jjagn/ebike-computer/ebike-controller.kicad_pcb

## KiCad design ebike-controller.kicad_pcb (2026-10-02)

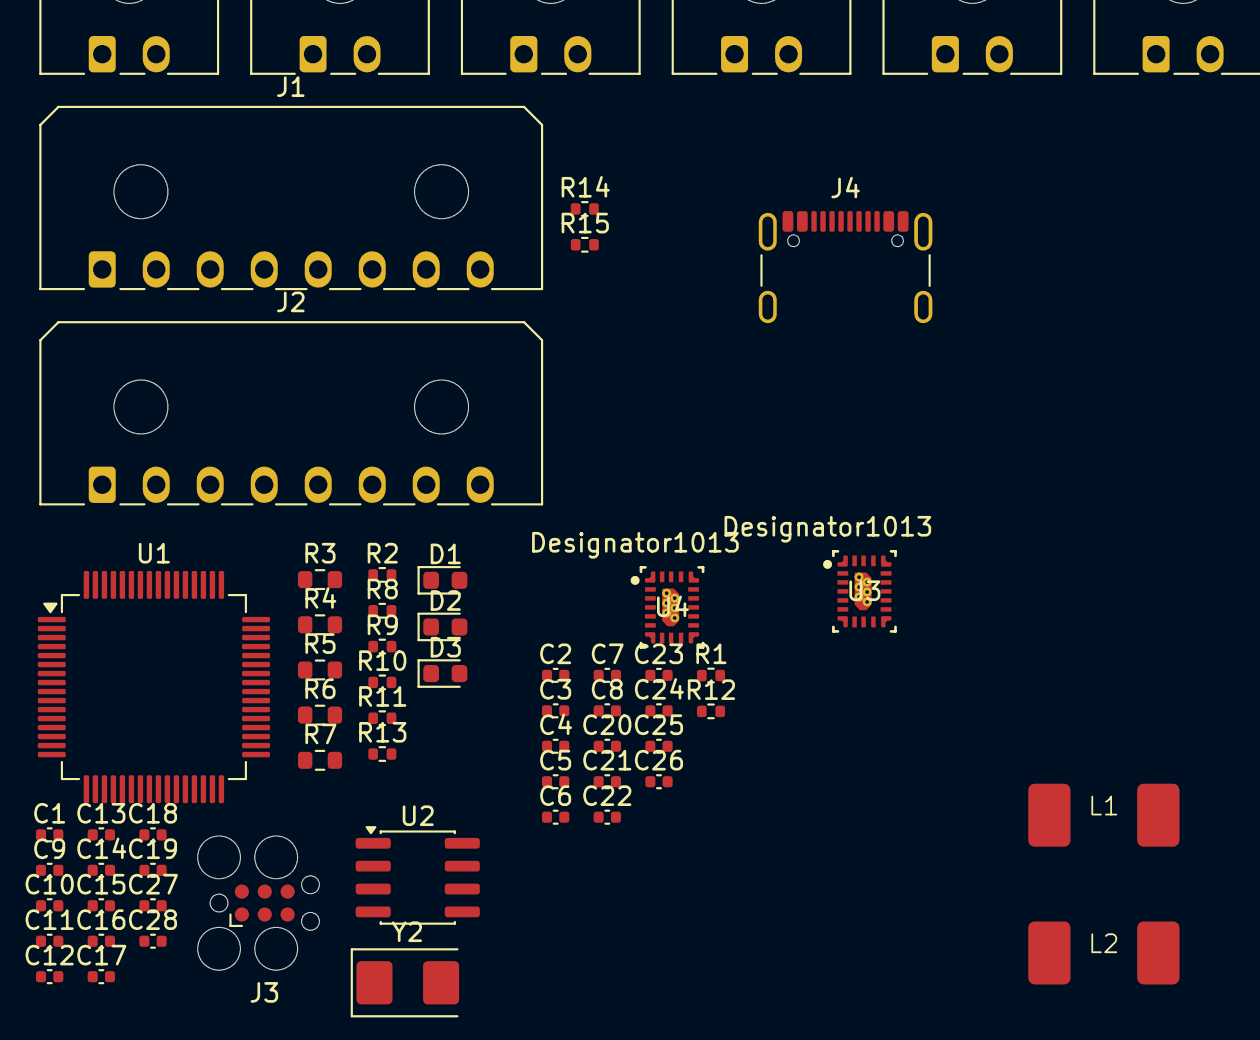
[picture p1: board ebike-controller.kicad_pcb from above]

Board: 2 copper layers, 63 parts (0 on the bottom side), 52 nets, no tracks yet.

Parts:
C1: 10uF; C_0402_1005Metric
C2, C24: 0.1uF; C_0402_1005Metric
C3, C4, C20, C21: 4.7uF; C_0402_1005Metric
C5, C6, C22, C23: 100nF; C_0402_1005Metric
C7: 94uF; C_0402_1005Metric
C8, C17, C25: 1uF; C_0402_1005Metric
C9, C10, C27, C28: 2.2uF; C_0402_1005Metric
C11, C12, C13, C14, C15, C16: 100nf; C_0402_1005Metric
C18, C19: 15pF; C_0402_1005Metric
C26: 55uF; C_0402_1005Metric
D1: RED; LED_0603_1608Metric
D2: GREEN; LED_0603_1608Metric
D3: BLUE; LED_0603_1608Metric
J1, J2: Conn_01x08; Molex_Micro-Fit_3.0_43650-0800_1x08_P3.00mm_Horizontal
J3: Tag Connect; Tag-Connect_TC2030-IDC-FP_2x03_P1.27mm_Vertical
J4: USB_C_Receptacle_USB2.0_14P; USB_C_Receptacle_GCT_USB4105-xx-A_16P_TopMnt_Horizontal
J5, J6, J7, J8, J9, J10: Conn_01x02; Molex_Micro-Fit_3.0_43650-0200_1x02_P3.00mm_Horizontal
L1: 6.8uH; Inductor_SMD_7.4mmx6.6mm
L2: 8.2uH; Inductor_SMD_7.4mmx6.6mm
R1, R2, R12: 100k; R_0402_1005Metric
R3, R4, R5, R6, R7: 0R; R_0603_1608Metric
R8: 120R; R_0402_1005Metric
R9, R11: 220R; R_0402_1005Metric
R10: 1k; R_0402_1005Metric
R13: 10k; R_0402_1005Metric
R14, R15: 5.1k; R_0402_1005Metric
U1: STM32F405RGTx; LQFP-64_10x10mm_P0.5mm
U2: TCAN330; SOIC-8_3.9x4.9mm_P1.27mm
U3, U4: LM65625SRZTR; RZT0020A-MFG
Y2: Crystal_GND2_Small; Crystal_SMD_5032-2Pin_5.0x3.2mm

Connections:
+3V3: C1.1, C7.1, C12.1, C13.1, C14.1, C15.1, C16.1, C17.1, C27.2, C28.2, J1.4, J2.2, J3.1 (VCC), L1.2, U1.1 (VBAT), U1.13 (VDDA), U1.19 (VDD), U1.32 (VDD), U1.48 (VDD), U1.64 (VDD), U2.3 (VCC), U3.20 (BIAS)
+5V: C26.1, J2.1, J4.A4 (VBUS), J4.A9 (VBUS), J4.B4 (VBUS), J4.B9 (VBUS), J10.1, L2.2, U4.20 (BIAS)
/IO/CAN_H: J5.1, R8.1, U2.7 (CANH)
/IO/CAN_L: J5.2, R8.2, U2.6 (CANL)
/IO/GPIO0: J2.3, U1.14 (PA0)
/IO/GPIO1: J2.4, U1.15 (PA1)
/IO/GPIO2: J2.5, U1.16 (PA2)
/IO/GPIO3: J2.6, U1.17 (PA3)
/IO/GPIO4: J2.7, U1.20 (PA4)
/IO/USB.DM: J4.A7 (D-), J4.B7 (D-)
/IO/USB.DP: J4.A6 (D+), J4.B6 (D+)
/IO/display.CS: J1.1, U1.33 (SPI2_NSS)
/IO/display.DC: J1.2, U1.30 (PB11)
/IO/display.RES: J1.3, U1.34 (PB13)
/IO/display.SCK: J1.5, U1.29 (SPI2_SCK)
/IO/display.SDA(MOSI): J1.6, U1.36 (SPI2_MOSI)
/MCU/CAN_RX: R3.2, R6.1, U2.4 (RXD)
/MCU/CAN_TX: R4.2, R7.1, U2.1 (TXD)
/MCU/NRST: C11.1, J3.3 (~RESET), U1.7 (NRST)
/MCU/OSC32_IN: C18.2, U1.5 (RCC_OSC_IN), Y2.1
/MCU/OSC32_OUT: R5.1, U1.6 (RCC_OSC_OUT)
/MCU/SWCLK: J3.4 (SWCLK), U1.49 (SYS_JTCK-SWCLK)
/MCU/SWDIO: J3.2 (SWDIO), U1.46 (SYS_JTMS-SWDIO)
/MCU/SWO: J3.6 (SWO), U1.55 (SYS_JTDO-SWO)
/Power/LM656_3V3_VCC: C8.1, R1.1, U3.4 (VCC), U3.6 (RT)
/Power/LM656_5V_VCC: C25.1, R12.1, U4.3 (FB), U4.4 (VCC), U4.6 (RT)
GND: C1.2, C7.2, C8.2, C9.1, C10.1, C11.2, C12.2, C13.2, C14.2, C15.2, C16.2, C17.2, C18.1, C19.2, C25.2, C26.2, D1.1 (K), D2.1 (K), D3.1 (K), J1.7, J1.8, J2.8, J3.5 (GND), J4.A1 (GND), J4.A12 (GND), J4.B1 (GND), J4.B12 (GND), J4.SH (SHIELD), J6.2, J7.2, J8.2, J9.2, J10.2, R13.1, R14.2, R15.2, U1.18 (VSS), U1.63 (VSS), U2.2 (GND), U3.3 (FB), U3.5 (MODE/SYNC), U3.9 (PGND1), U3.19 (PGND2), U4.5 (MODE/SYNC), U4.9 (PGND1), U4.19 (PGND2), Y2.2
GNDA: C27.1, C28.1, U1.12 (VSSA)
unnamed: C19.1, R5.2
unnamed: D1.2 (A), R11.1
unnamed: D2.2 (A), R9.1
unnamed: D3.2 (A), R10.1
unnamed: J4.A5 (CC1), R14.1
unnamed: J4.B5 (CC2), R15.1
unnamed: R2.2, U1.60 (BOOT0)
unnamed: R13.2, U1.28 (PB2)
unnamed: R3.1, R7.2, U1.61 (CAN1_RX)
unnamed: R4.1, R6.2, U1.62 (CAN1_TX)
unnamed: R11.2, U1.8 (PC0)
unnamed: R9.2, U1.9 (PC1)
unnamed: R10.2, U1.10 (PC2)
unnamed: C9.2, U1.31 (VCAP_1)
unnamed: C10.2, U1.47 (VCAP_2)
unnamed: C2.1, U3.15 (BOOT)
unnamed: C3.2, C4.2, C5.2, C6.2, U3.7 (EN/UVLO), U3.11 (VIN1), U3.17 (VIN2)
unnamed: R1.2, U3.2 (PG)
unnamed: C2.2, L1.1, U3.13 (SW1), U3.14 (SW2)
unnamed: C24.1, U4.15 (BOOT)
unnamed: C20.2, C21.2, C22.2, C23.2, U4.7 (EN/UVLO), U4.11 (VIN1), U4.17 (VIN2)
unnamed: R12.2, U4.2 (PG)
unnamed: C24.2, L2.1, U4.13 (SW1), U4.14 (SW2)
VCC: C3.1, C4.1, C5.1, C6.1, C20.1, C21.1, C22.1, C23.1, J8.1, J9.1
