jjagn/ebike-computer/(commit log)

2026-08-25 improving architecture of schematic
    [ebike-controller.kicad_sch, mcu.kicad_sch, power.kicad_sch]
2026-08-26 progress checkin
    [ebike-controller.kicad_sch, io.kicad_sch, led-drivers.kicad_sch, mcu.kicad_sch, power.kicad_sch]
2026-09-08 assigning footprints
    [ebike-controller.kicad_pcb, io.kicad_sch, mcu.kicad_sch, power.kicad_sch]
2026-10-02 Snapshot before schematic review fixes
    [ebike-controller.kicad_pcb, io.kicad_sch, mcu.kicad_sch, power.kicad_sch]
2026-10-02 Fix schematic review findings
    Power:
    - Input caps were in series with VIN; now VIN->GND, VIN tied to supply
    - U4 (5V) runs from protected battery rail: 60V PTC, SS210 reverse-
    polarity diode, SMBJ43A TVS, 47uF/100V bulk; EN UVLO divider (30.3V/24.2V)
    - U3 (3V3) cascaded from +5V so the MCU runs on USB power too
    - TPS2116 power mux: buck has priority, USB VBUS fallback, no backfeed
    - Output caps redesigned per TI Table 8-1 (LM6xx25 column); L2 -> 10uH
    - U3 PG drives NRST (pulled to 3V3)
    - Project LM656x5 symbol: EP numbered 21, PG/RT/MODE/VCC pin types fixed,
    limit text 65V (stock KiCad symbol had all of these wrong)
    - New TI_RZT0020A footprint per TI land pattern 4228518/C
    MCU / IO:
    - G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
    [ebike-controller.kicad_sch, io.kicad_sch, mcu.kicad_sch, power.kicad_sch]
2026-10-19 Update PCB and schematics after review fixes
2026-10-19 Add schematic review and fix documentation
